gilsonfiho/lora-water-pump-control/hardware/fab/emissor/emissor_bottom.png

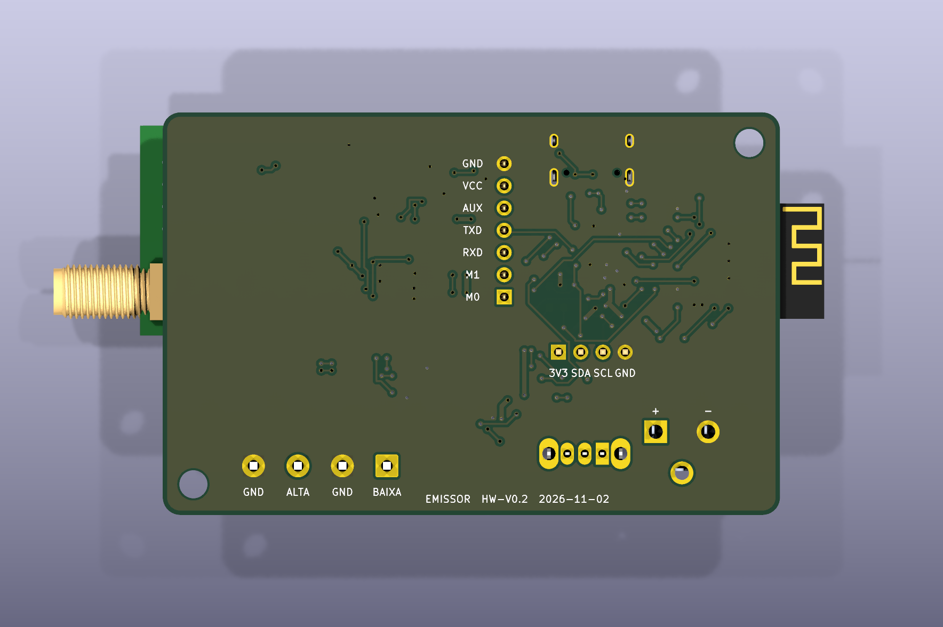
hardware/fab/emissor/emissor_bottom.png
