gilsonfiho/lora-water-pump-control/hardware/fab/receptor/receptor_top.png

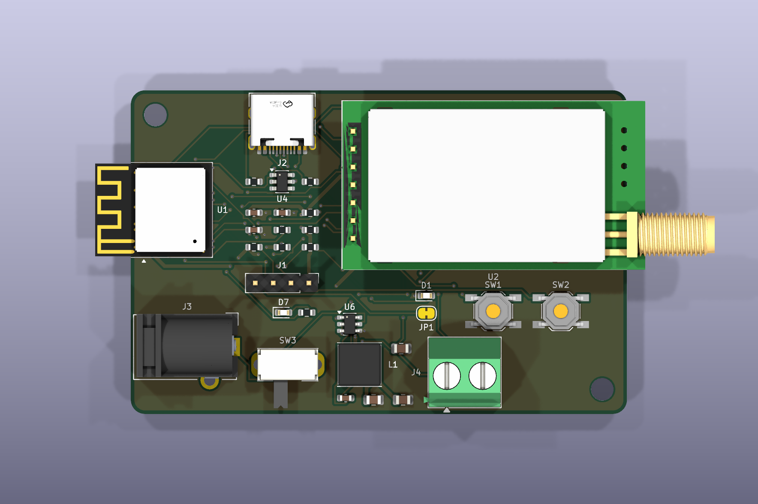
hardware/fab/receptor/receptor_top.png
