gilsonfiho/lora-water-pump-control/hardware/emissor/power.kicad_sch

## KiCad design hardware/emissor/power.kicad_sch (2026-11-03)

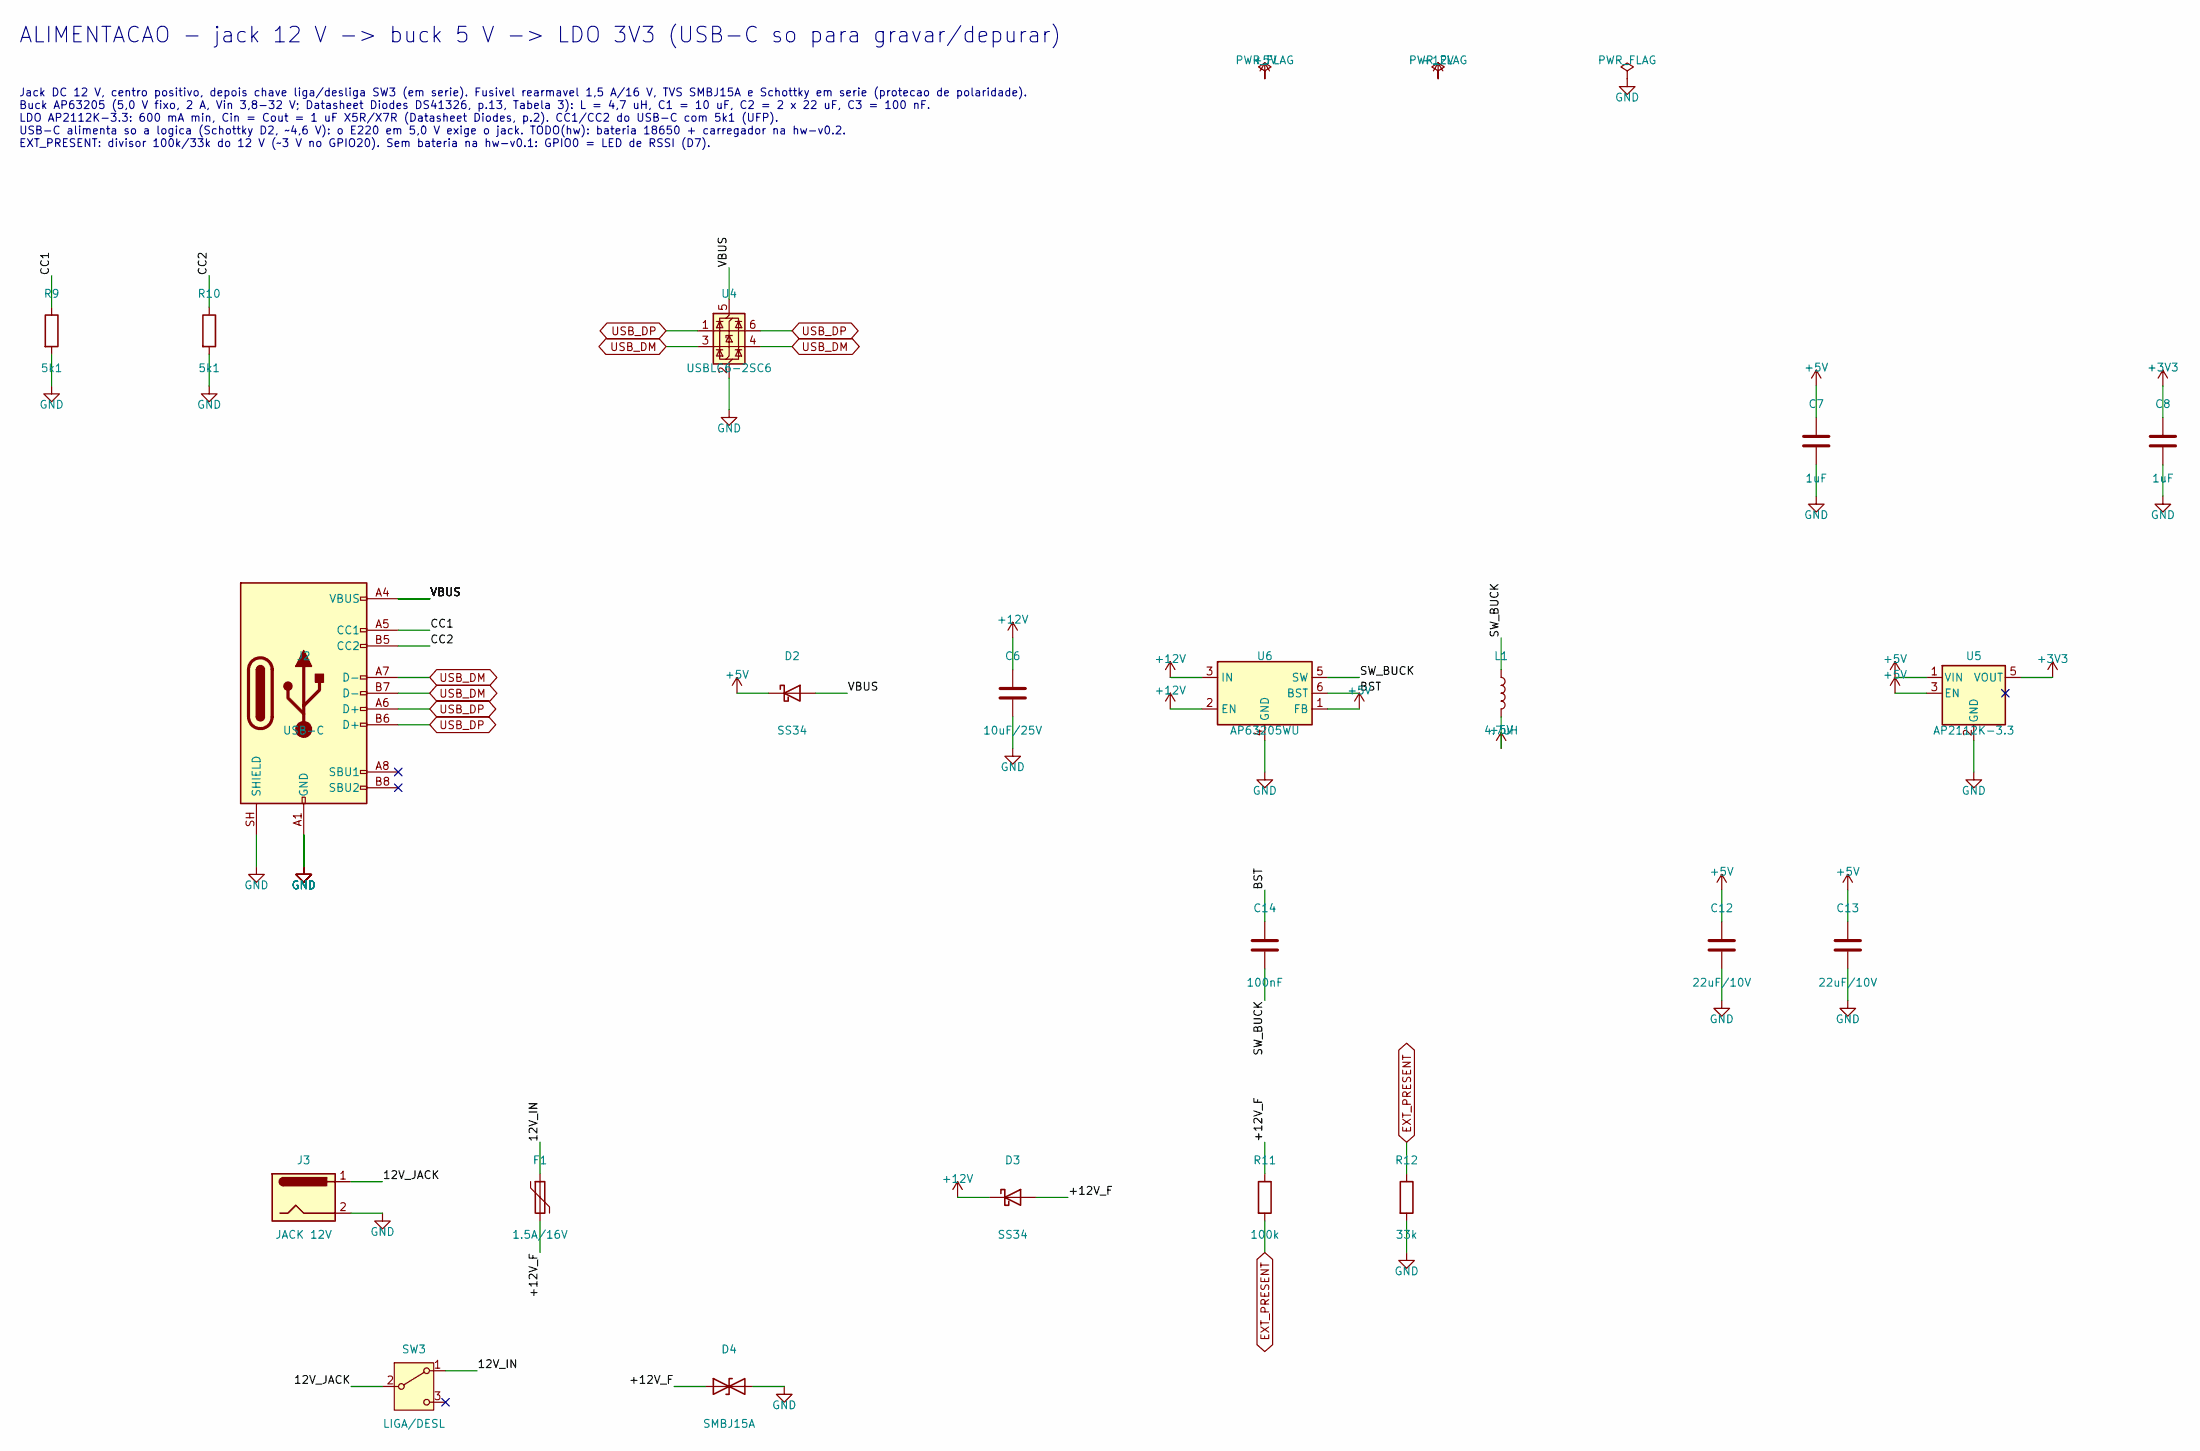
[picture p3: schematic power.kicad_sch]

Parts:
C6: 10uF/25V; C_0805_2012Metric; MPN CL21A106KAYNNNE
C7, C8: 1uF; C_0603_1608Metric; MPN CL10A105KB8NNNC
C12, C13: 22uF/10V; C_0805_2012Metric; MPN CL21A226MPQNNNE
C14: 100nF; C_0603_1608Metric; MPN CL10B104KB8NNNC
D2, D3: SS34; D_SMA; MPN SS34
D4: SMBJ15A; D_SMB; MPN SMBJ15A
F1: 1.5A/16V; Fuse_1206_3216Metric; MPN MF-MSMF150/16X-2
J2: USB-C; USB_C_Receptacle_HRO_TYPE-C-31-M-12; MPN TYPE-C-31-M-12
J3: JACK 12V; BarrelJack_CUI_PJ-102AH_Horizontal; MPN PJ-102AH
L1: 4.7uH; L_Taiyo-Yuden_NR-60xx; MPN NR6045T4R7M
R9, R10: 5k1; R_0603_1608Metric; MPN RC0603FR-075K1L
R11: 100k; R_0603_1608Metric; MPN RC0603FR-07100KL
R12: 33k; R_0603_1608Metric; MPN RC0603FR-0733KL
SW3: LIGA/DESL; SW_Slide_SPDT_Angled_CK_OS102011MA1Q; MPN TODO(hw): chave deslizante >= 2 A / 16 V
U4: USBLC6-2SC6; SOT-23-6; MPN USBLC6-2SC6
U5: AP2112K-3.3; SOT-23-5; MPN AP2112K-3.3TRG1
U6: AP63205WU; TSOT-23-6; MPN AP63205WU-7

Connections:
12V_IN: F1.1, SW3.1 (A)
12V_JACK: J3.1, SW3.2 (B)
+3V3: C8.1, U5.5 (VOUT)
+5V: C7.1, C12.1, C13.1, D2.1 (K), L1.2, U5.1 (VIN), U5.3 (EN), U6.1 (FB)
+12V: C6.1, D3.1 (K), U6.2 (EN), U6.3 (IN)
+12V_F: D3.2 (A), D4.1 (A1), F1.2, R11.1
BST: C14.1, U6.6 (BST)
CC1: J2.A5 (CC1), R9.1
CC2: J2.B5 (CC2), R10.1
EXT_PRESENT: R11.2, R12.1
GND: C6.2, C7.2, C8.2, C12.2, C13.2, D4.2 (A2), J2.A1 (GND), J2.A12 (GND), J2.B1 (GND), J2.B12 (GND), J2.SH (SHIELD), J3.2, R9.2, R10.2, R12.2, U4.2 (GND), U5.2 (GND), U6.4 (GND)
SW_BUCK: C14.2, L1.1, U6.5 (SW)
USB_DM: J2.A7 (D-), J2.B7 (D-), U4.3 (I/O2), U4.4 (I/O2)
USB_DP: J2.A6 (D+), J2.B6 (D+), U4.1 (I/O1), U4.6 (I/O1)
VBUS: D2.2 (A), J2.A4 (VBUS), J2.A9 (VBUS), J2.B4 (VBUS), J2.B9 (VBUS), U4.5 (VBUS)

Notes on the sheet:
ALIMENTACAO - jack 12 V -> buck 5 V -> LDO 3V3 (USB-C so para gravar/depurar)
Jack DC 12 V, centro positivo, depois chave liga/desliga SW3 (em serie). Fusivel rearmavel 1,5 A/16 V, TVS SMBJ15A e Schottky em serie (protecao de polaridade). Buck AP63205 (5,0 V fixo, 2 A, Vin 3,8-32 V; Datasheet Diodes DS41326, p.13, Tabela 3): L = 4,7 uH, C1 = 10 uF, C2 = 2 x 22 uF, C3 = 100 n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
