gilsonfiho/lora-water-pump-control/hardware/emissor/radio.kicad_sch

## KiCad design hardware/emissor/radio.kicad_sch (2026-11-03)

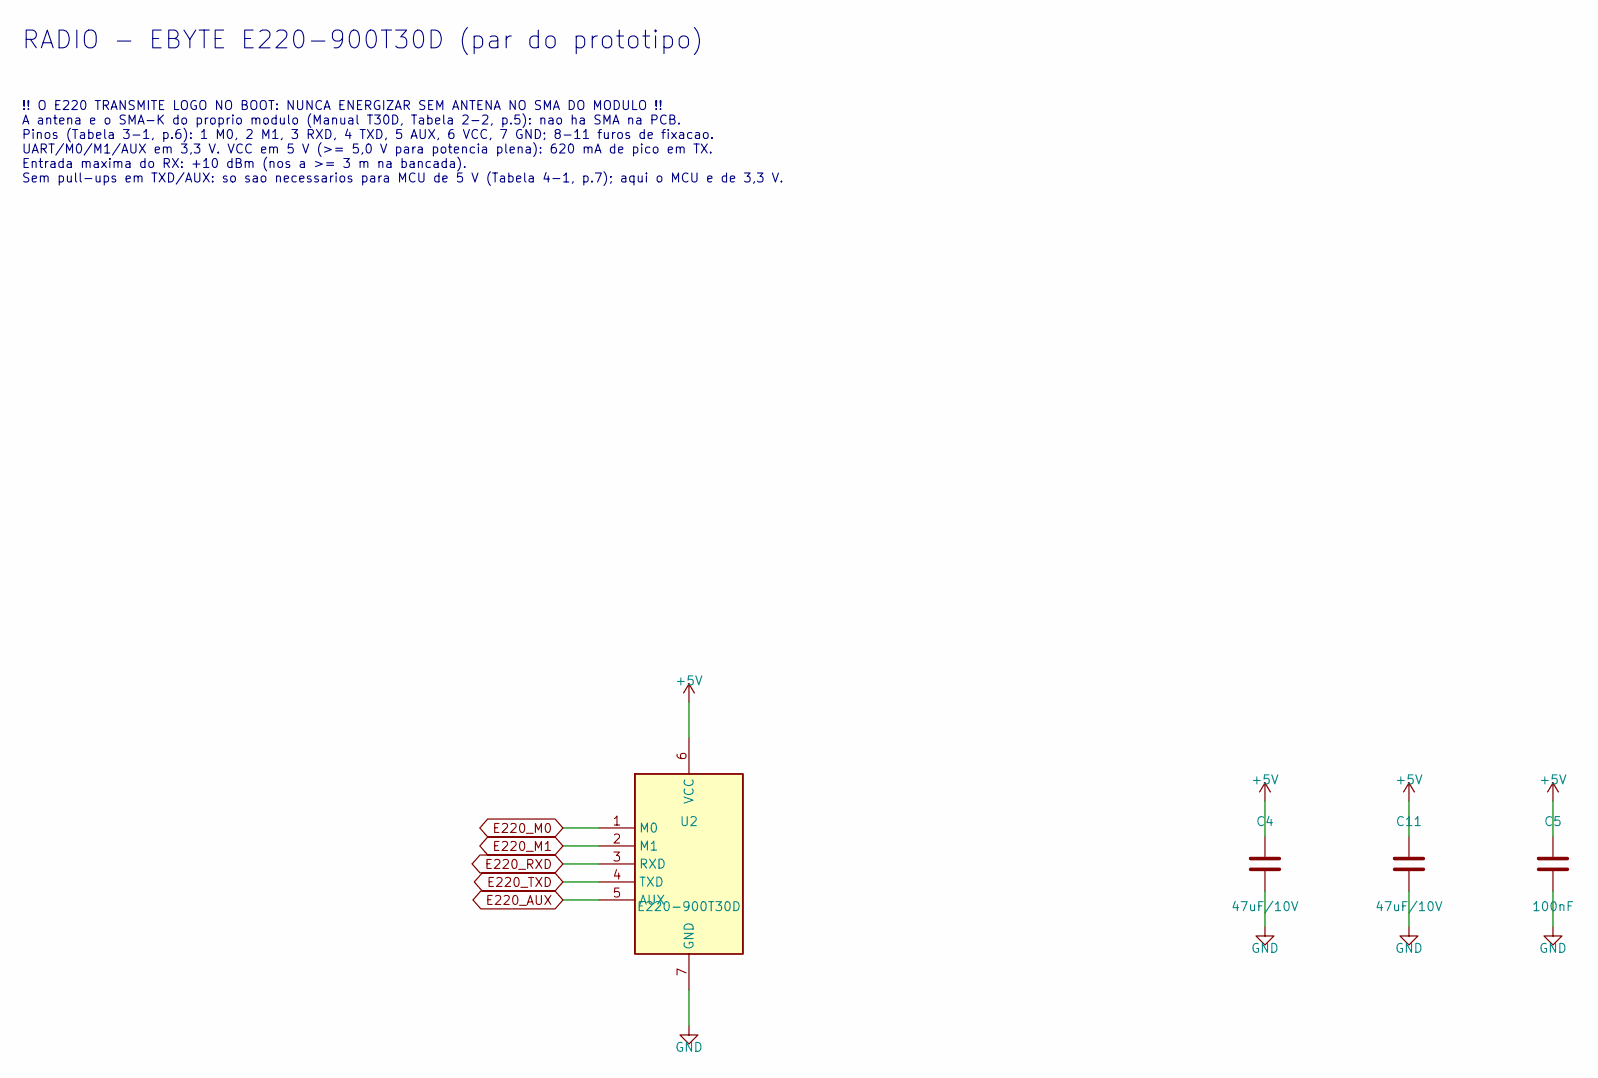
[picture p4: schematic radio.kicad_sch]

Parts:
C4, C11: 47uF/10V; C_1210_3225Metric; MPN CL32A476MPVNNNE
C5: 100nF; C_0603_1608Metric; MPN CL10B104KB8NNNC
U2: E220-900T30D; MPN E220-900T30D

Connections:
+5V: C4.1, C5.1, C11.1, U2.6 (VCC)
E220_AUX: U2.5 (AUX)
E220_M0: U2.1 (M0)
E220_M1: U2.2 (M1)
E220_RXD: U2.3 (RXD)
E220_TXD: U2.4 (TXD)
GND: C4.2, C5.2, C11.2, U2.7 (GND)

Notes on the sheet:
RADIO - EBYTE E220-900T30D (par do prototipo)
!! O E220 TRANSMITE LOGO NO BOOT: NUNCA ENERGIZAR SEM ANTENA NO SMA DO MODULO !! A antena e o SMA-K do proprio modulo (Manual T30D, Tabela 2-2, p.5): nao ha SMA na PCB. Pinos (Tabela 3-1, p.6): 1 M0, 2 M1, 3 RXD, 4 TXD, 5 AUX, 6 VCC, 7 GND; 8-11 furos de fixacao. UART/M0/M1/AUX em 3,3 V. VCC em 5 V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
