gilsonfiho/lora-water-pump-control/(commit log)

2026-09-17 chore: configura projeto PlatformIO (ESP32-C3, 2 ambientes)
2026-09-17 feat(config): pinos, enderecos, timeouts e perfil de RF
2026-09-17 feat(hal): interfaces de abstracao de hardware
2026-09-17 feat(hal): driver LoRa E220 via UART
2026-09-17 feat(hal): esqueleto do driver SX127x via SPI (estrategia alternativa)
2026-09-17 feat(hal): sensores de nivel (boia padrao, ultrassonico opcional)
2026-09-17 feat(hal): monitores de bateria (ADC e INA219)
2026-09-17 feat(protocol): camada de enlace com ACK, retry e auto-ACK
2026-09-17 feat(core): observer e maquinas de estado dos nos
2026-09-17 feat(power): gerenciador de energia e deep sleep
2026-09-17 docs: arquitetura, protocolo e maquinas de estado
2026-09-17 docs(assets): diagrama de blocos da solucao
2026-09-18 docs: referencia o CHANGELOG e ajusta status para v0.0.1
2026-09-19 docs: adiciona notas de contexto e datasheets dos modulos E220
2026-09-19 refactor!: migra de PlatformIO/Arduino para ESP-IDF e monta perfil de bancada
2026-09-19 refactor!: renomeia camada hal para hw e compila com ESP-IDF 6.1
2026-09-19 feat(radio): canal 55 (905,125 MHz) e potencia de 10 dBm na bancada
2026-09-19 style: revisa comentarios de config e power
2026-09-19 docs: secao de bancada no README, analise ANATEL e build pela extensao
2026-09-19 docs(readme): passo a passo de gravacao por no e bancada com T30D
2026-09-20 feat(protocol): evento de diagnostico do enlace (LinkEvent + onEvent)
2026-09-20 feat(hw): log hex de TX/RX no E220 (nivel DEBUG)
2026-09-20 docs: registra o log de diagnostico do enlace
2026-09-26 docs: adiciona skills locais C++/ESP-IDF e regra de sem co-autor
    Skills globais de planejamento/engenharia sênior eram voltadas a
    Python/FastAPI; cria versões locais em .claude/skills/, com mesmo nome
    (prioridade neste repo), adaptadas ao firmware C++17/ESP-IDF. Adiciona
    também skill de simplicidade e documenta tudo em CLAUDE.md, junto com a
    regra de nunca usar trailer Co-Authored-By em commits/PRs deste repositório.
    Refs #11
2026-10-10 feat(protocol): mensagem BOMBA_STATUS (0x06)
    Novo tipo bomba -> reservatorio com estado do no, bloqueio por tempo maximo, estado da saida e segundos ligada (4 bytes). Informativo e sem ACK: o laco do atuador nao pode esperar confirmacao.
    O enum PumpNodeState e proprio do protocol/, espelhando core::PumpController::State, porque protocol/ nao pode depender de core/. A conversao fica na core/.
    O formato do quadro nao mudou, entao VER segue 0x01: o decodificador nao valida o tipo, e um no antigo ignora o desconhecido.
2026-10-10 feat(core): failsafe de tempo maximo de bombeamento (#9)
    O failsafe de enlace so age quando o radio cala. Boia travada, comando ON preso por bug ou trafego forjado mantinham a bomba ligada sem limite, com risco de dano ao motor por operacao a seco.
    O no da bomba passa a medir o tempo ligada por conta propria e desliga ao passar de kMaxPumpRunMs (60 s na bancada, 30 min em campo com TODO(hw)). Novo estado kOverrun.
    O bloqueio e um LATCH, nao apenas um estado: se fosse estado, um silencio de radio levaria a kLinkLost e o LIGAR seguinte religaria a bomba, o que tornaria o limite burlavel. So um DESLIGAR explicito rearma. Reenvios de LIGAR nao reiniciam o cronometro.
    O reservatorio passa a re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
2026-10-10 feat(platform): fonte de tempo substituivel para testes
    platform::setTimeSource() troca de onde millis() le o tempo. Sem isso, verificar um failsafe de 45 s ou um bloqueio de 30 min exigiria esperar de verdade. Em producao ninguem chama, e millis() segue no esp_timer.
2026-10-10 test: suite Unity rodando no QEMU
    55 casos sobre protocol/ e core/, sem placa: idf.py -C test qemu, ou .\test\run-tests.ps1 (carrega o ambiente, acrescenta o QEMU ao PATH, compila e roda).
    Cobre CRC-16 com vetor conhecido, ida e volta do quadro, corrupcao e truncamento, builders/parsers de cada mensagem, ACK/retry/timeout/auto-ACK/filtro de endereco do LinkLayer com radio falso e par de nos em loopback, os dois failsafes da bomba (incluindo o latch sobrevivendo a queda de enlace) e a histerese do reservatorio.
    Os TEST_CASE se registram por __attribute__((constructor)), entao o componente de teste precisa de WHOLE_ARCHIVE: sem isso o linker descarta os objetos e o Unity nao encontra teste n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
2026-10-10 docs: failsafe de tempo maximo, BOMBA_STATUS e secao de testes
2026-10-10 fix(protocol): heartbeat e auto-ACK adiavam a retransmissao
    transmit() atualizava lastTxMs_, que e o relogio da transacao confiavel em voo -- nao de qualquer TX. Com isso, um sendOnce() (heartbeat a cada 5 s, telemetria a cada 15 s) ou o auto-ACK de um pacote recebido reiniciavam a espera do ACK. Com kAckTimeoutMs de 800 ms, o comando pendente podia nunca ser retransmitido nem falhar.
    Agora so sendReliable() e a retransmissao em poll() tocam esse relogio.
    Tres testes de regressao cobrem os dois caminhos (heartbeat e auto-ACK no meio da janela, e trafego constante sem ACK ainda falhando a entrega). O teste 'nao empilha transacoes' foi reescrito: ele assumia um unico SEQ, o que so acontecia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
2026-10-10 docs: failsafe de tempo maximo, BOMBA_STATUS, testes e correcao do enlace
2026-10-10 fix(core): begin() nao transmite, src pelo LinkLayer e tempo ligada no bloqueio
    A app chama controller.begin() antes de radio.begin(), porque o rele precisa ir ao estado seguro antes de qualquer espera de hardware. O begin() passava por enter(), que reportava BOMBA_STATUS por uma UART ainda nao instalada: uart_write_bytes loga 'uart driver error' nesse caso, e o no da bomba imprimia esse erro em todo boot -- ruido justamente em quem depura enlace pelo log. O estado inicial passa a ser definido direto, e o primeiro status sai na primeira transicao real.
    O src do BOMBA_STATUS vai em 0: quem preenche e o LinkLayer, com o endereco local. O controlador nao precisa supor o proprio endereco.
    runS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
2026-10-11 feat(platform): fonte de nonce substituivel para anti-replay
2026-10-11 feat(core): bomba descarta pacote de src inesperado
2026-10-12 chore(hw): estrutura do projeto de PCB em hardware/
2026-10-12 docs(hw): fixa KiCad 10 como versao do projeto
2026-10-12 chore(hw): ignora arquivos de terceiros baixados (3D e datasheets)
2026-10-12 feat(hw): esqueleto do projeto KiCad 10 (sch e pcb vazios)
2026-10-12 docs(hw): mapa de pinos proposto e premissas de arquitetura
2026-10-12 docs(hw): corrige o caminho do Python do KiCad no README
2026-10-12 docs(hw): caminho do Python do KiCad no README
2026-10-12 docs: skill local pcb-design para as placas em hardware/
2026-10-12 feat(hw): layout compacto de 86x52 mm nas duas placas
2026-10-12 wip(hw): roteador proprio, layout v2 com pecas sob o E220 (checkpoint antes de trocar para jack 12 V)
2026-10-12 feat(hw): jack 12 V com buck AP63205, roteador proprio e serigrafia padronizada (receptor roteado; emissor com 1 net aberta)
2026-10-12 feat(hw): placas roteadas com ~120 vias; falta 1 net por placa (E220_RXD e PUMP_DRV)
2026-10-12 feat(hw): serigrafia de tras enxuta: identificacao e pinagem colada aos conectores
2026-10-12 feat(hw): tira a identificacao de tras (ja esta na frente)
2026-10-12 feat(hw): modelo 3D oficial da EBYTE para o E220; remove os 4 furos de fixacao
2026-10-12 feat(hw): modelos 3D reais do E220, ESP32-C3, USB-C e jack (fora do Git em libs/vendor)
2026-10-12 feat(hw): soquete do E220, chave liga/desliga, USB-C afastado e layout reorganizado
    - E220 plugavel em soquete femea 1x07 (modelo 3D do soquete, modulo elevado 8,5 mm)
    - chave liga/desliga SW3 em serie com o jack (rede 12V_JACK); corrente a confirmar (TODO hw)
    - USB-C e ESD afastados do ESP32-C3; C3 em altura intermediaria na esquerda
    - furo de fixacao M3 no canto superior esquerdo; jack na borda esquerda
    - zona proibida da antena reduzida ao retangulo oficial da Espressif + 3 mm
    - identificacao tambem na face de baixo, em uma linha
    - DRC: so avisos de serigrafia na borda; ERC sem erros
2026-10-14 feat(hw): corrige o 3D do ESP32-C3 e encurta a placa para 74 x 46 mm
    - offset do modelo 3D do C3 corrigido (-5,67): a antena ja ficava rente a borda no footprint
    - componentes a direita do C3 recuados 2 mm; placa de 76 para 74 mm de largura
    - DRC: so avisos de serigrafia na borda; ERC sem erros (seeds 40 e 96)
2026-10-15 feat(hw): antena do ESP32-C3 para fora da borda e placa de 70,5 x 46 mm
    - regiao da antena (5,2 mm) pendurada alem da borda esquerda, como no devkit S3
    - componentes a direita do C3 recuados 5,5 mm; buck passa a usar y 31,5 a 45,6
    - DRC: so avisos de serigrafia na borda; ERC sem erros (seeds 96 e 0)
2026-11-02 chore(hw): tira os scripts geradores do Git e marca a revisao hw-v0.1 das PCBs
    - hardware/tools/ no .gitignore (removido do historico da branch)
    - README, skill pcb-design e decisoes.md atualizados: os arquivos KiCad sao a fonte
    - CHANGELOG: placas roteadas, ERC/DRC sem erros
2026-11-02 feat(hw): LED de RSSI no GPIO0, grade alinhada e 3D do indutor L1
    - D7 ambar + R18 330 ohm no GPIO0 do C3, nas duas placas (issue #18)
    - D7/R18 acima da SW3, J1 centralizado, USB-C mais a esquerda
    - passivos do C3 em grade 3x3 alinhada a R9/U4/R10
    - L1 usa o envelope L_APV_ANR6045 (o .step do footprint nao existe no KiCad 10)
    - renders e STEP regenerados; DRC so com 3 avisos de serigrafia por placa
2026-11-02 feat(firmware): LED de RSSI piscando conforme o ultimo pacote valido (#17)
    - hw::ISignalIndicator + GpioSignalIndicator; core::RssiIndicator (3 faixas,
    pulso de 100 ms, apaga apos kLinkLostTimeoutMs sem pacote valido)
    - LinkEvent::kRxValid com o RSSI, emitido so apos CRC, MAC e anti-replay
    - appendRssi ligado (regravar os dois nos juntos); RSSI logado a cada RX valido
    - pinos alinhados a PCB hw-v0.2: LED de RSSI no GPIO0, bomba movida para o GPIO1
    - faixas e tempos em cfg::Indicator (TODO(hw): calibrar em campo)
    - 8 testes novos (76/76 no QEMU); docs de bancada, status e decisoes atualizados
2026-11-02 chore: restaura o fim de linha original dos arquivos tocados
    Os scripts de edicao regravaram 23 arquivos com CRLF; o repositorio usa LF
    (CHANGELOG.md segue CRLF). Sem efeito de codigo: so tira o ruido do diff.
2026-11-02 docs: registra a versao 0.0.6 (LED de RSSI) no CHANGELOG e no status
2026-11-02 chore: CHANGELOG.md volta ao fim de linha CRLF original
